rolandspannagl/WSPR-HAT/Documents/WSPRShield-BOT.pdf

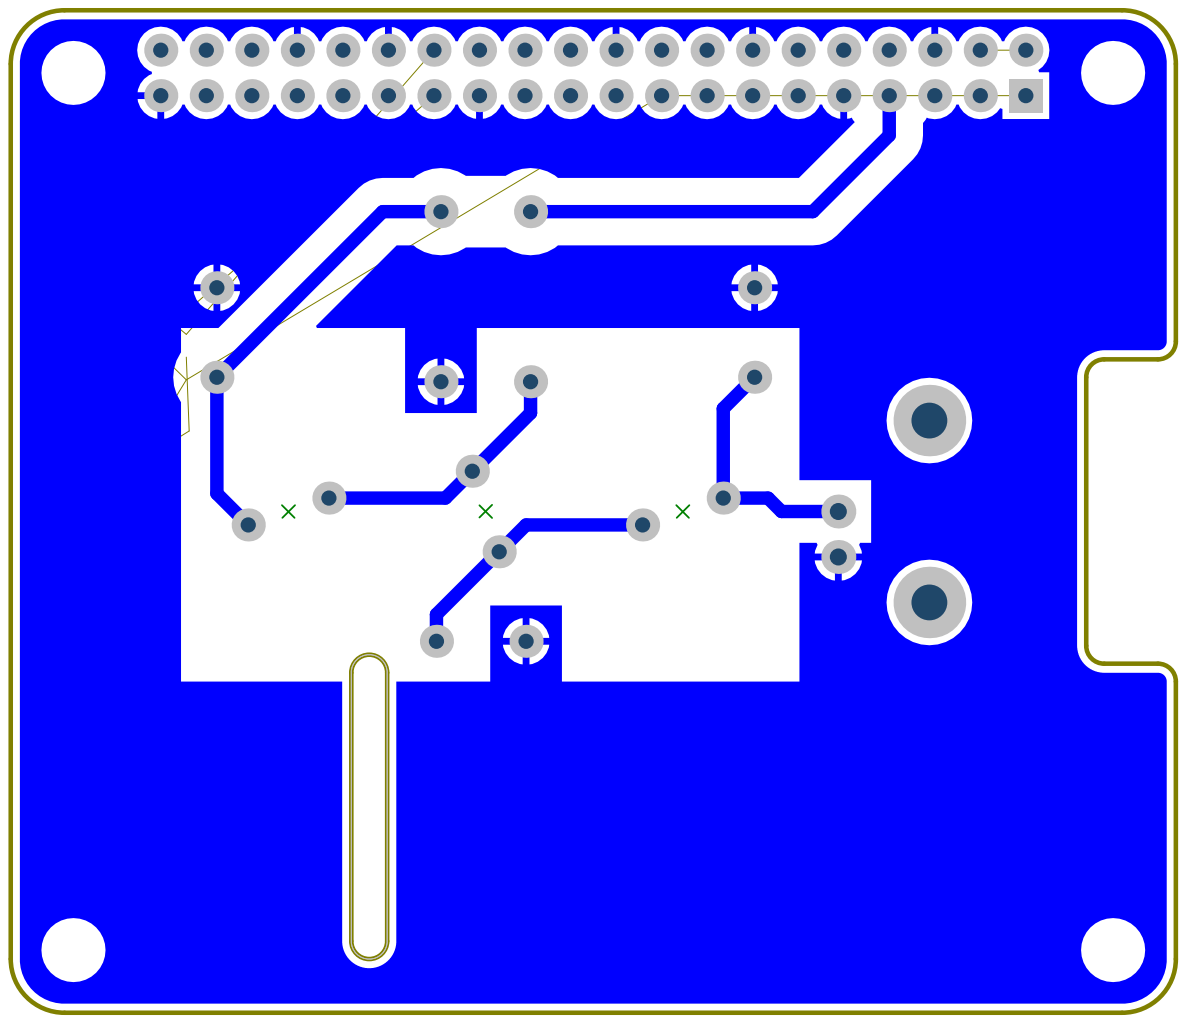
[picture p4: page 1]
