rolandspannagl/WSPR-HAT/Documents/WSPRShield-TOP.pdf

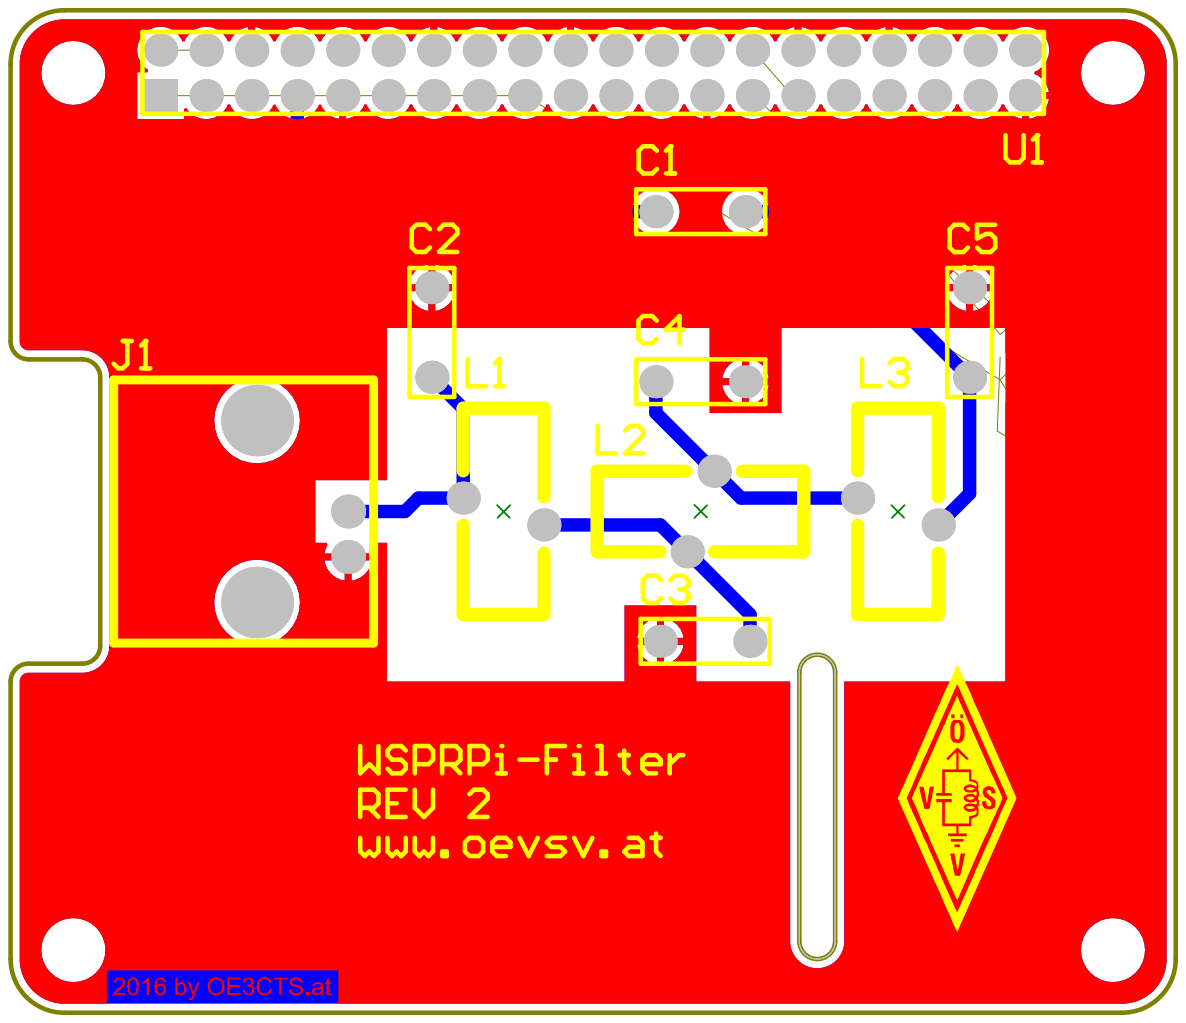
[picture p5: page 1]
