rolandspannagl/WSPR-HAT/(list of files, drawings)

Other design files:
Design/WSPRShield.PrjPcb
Design/WSPRShield.SchDoc
