rolandspannagl/WSPR-HAT/(commit log)

2016-06-12 Schaltplan + pcb aktualisiert
    [WSPRShield.PrjPcb, WSPRShield.SchDoc]
2016-07-16 updated data for REV2
    [WSPRShield.PrjPcb, WSPRShield.SchDoc]
2016-10-06 moved files
    [WSPRShield.PrjPcb, WSPRShield.SchDoc]
